mmzarif/moodclip/stl/backplate.stl

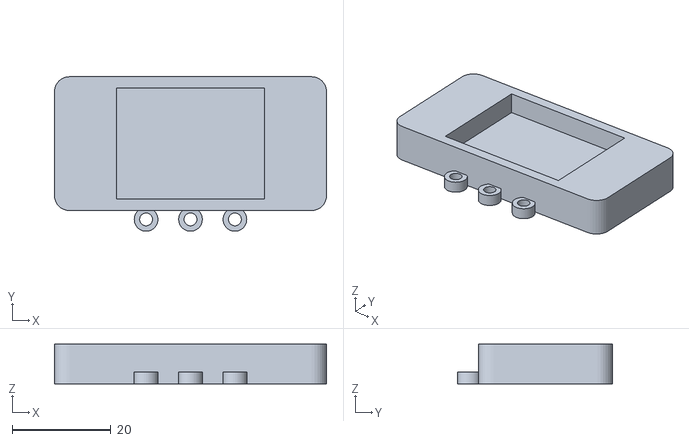
[picture p1: CAD file, 2026-10-12]
stl/backplate.stl
55.1 x 31.3 x 8.10
