mmzarif/moodclip/stl/tray.stl

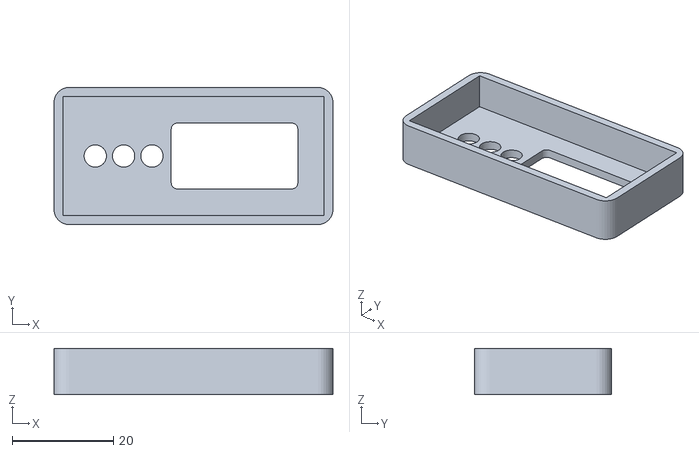
[picture p2: CAD file, 2026-10-12]
stl/tray.stl
55.1 x 27.1 x 9.15
