mmzarif/moodclip/stl/ALL_moodclip_plate.stl

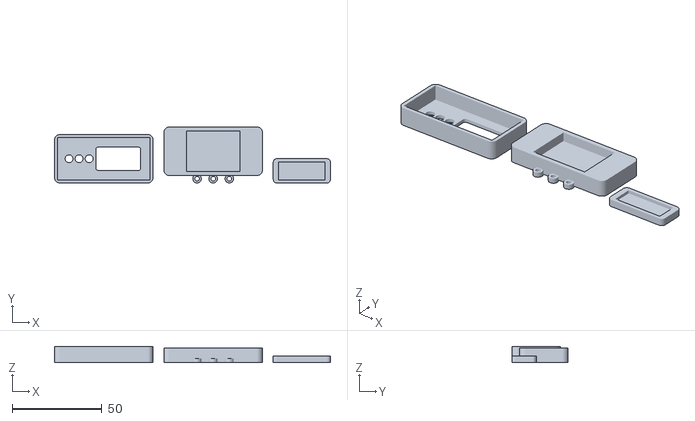
[picture p3: CAD file, 2026-10-12]
stl/ALL_moodclip_plate.stl
154.2 x 31.3 x 9.15
