mmzarif/moodclip/stl/clip_shoe.stl

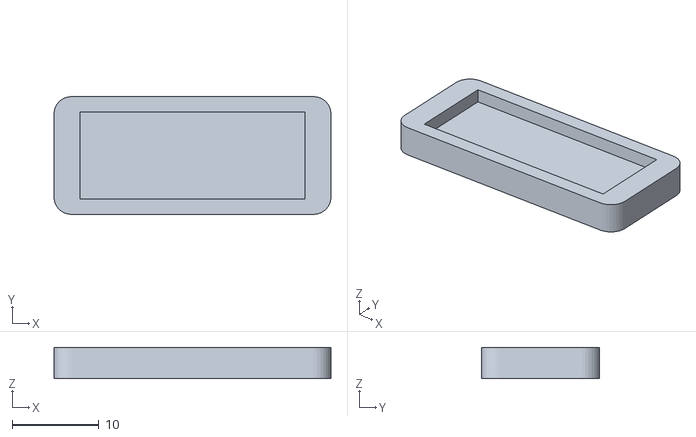
[picture p4: CAD file, 2026-10-12]
stl/clip_shoe.stl
32.0 x 13.6 x 3.60
